josephvcaustin/SeniorDesign1/Rasberry Pi/Histogram Equalization/test_image3.jpg

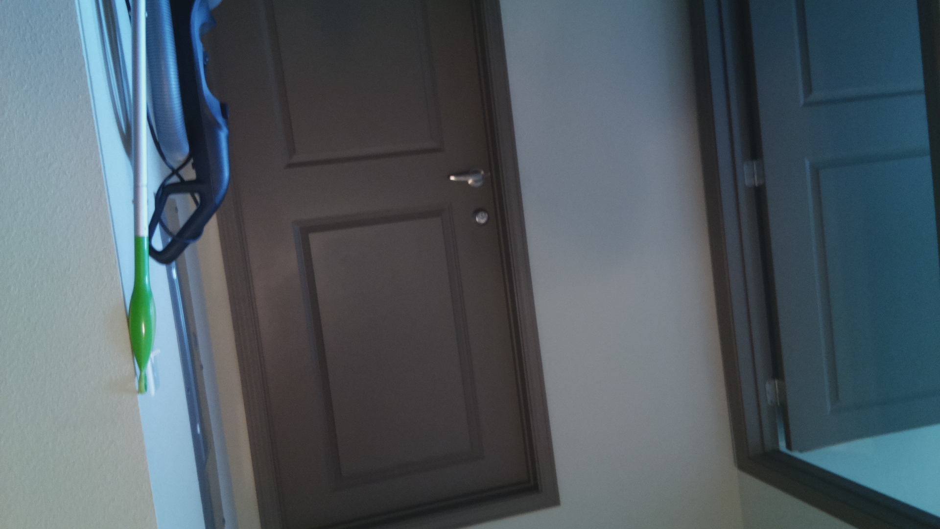
Rasberry Pi/Histogram Equalization/test_image3.jpg
