josephvcaustin/SeniorDesign1/Rasberry Pi/Interfacing and Testing Vehicle/CarRight.bmp

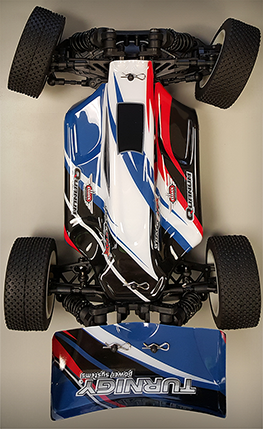
Rasberry Pi/Interfacing and Testing Vehicle/CarRight.bmp
