josephvcaustin/SeniorDesign1/README.md

# SeniorDesign1
A repository for all code related to the 2016 Senior Design Challenge at Oklahoma State University: the development of a high speed, autonomous, line-following vehicle.

For a video demonstration, see https://www.youtube.com/watch?v=CCHoqI0AoAU
