josephvcaustin/SeniorDesign1/Rasberry Pi/Camera/res.png

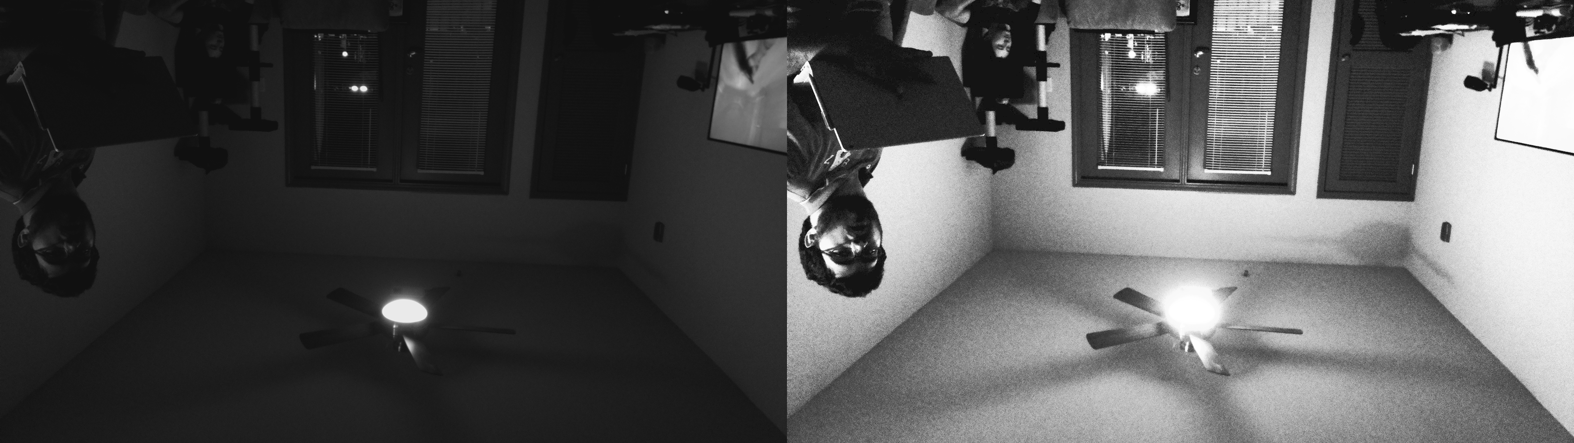
Rasberry Pi/Camera/res.png
