josephvcaustin/SeniorDesign1/Rasberry Pi/Camera/straight.png

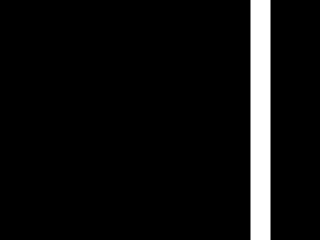
Rasberry Pi/Camera/straight.png
