josephvcaustin/SeniorDesign1/Rasberry Pi/Camera/turn2.png

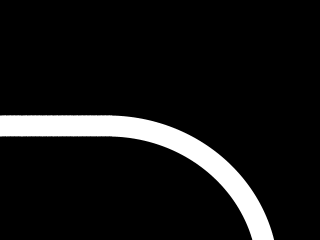
Rasberry Pi/Camera/turn2.png
