josephvcaustin/SeniorDesign1/Rasberry Pi/Camera/turn.png

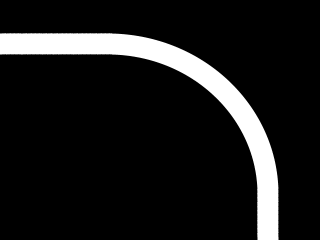
Rasberry Pi/Camera/turn.png
