josephvcaustin/SeniorDesign1/Rasberry Pi/Camera/test_image2.jpg

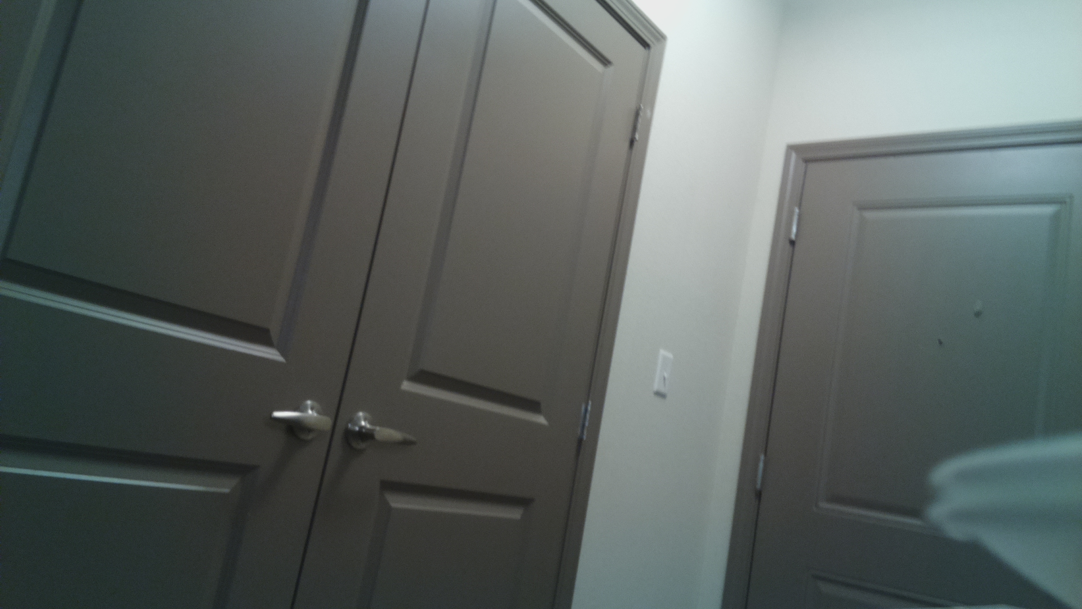
Rasberry Pi/Camera/test_image2.jpg
