josephvcaustin/SeniorDesign1/Rasberry Pi/Histogram Equalization/test_imag.jpg

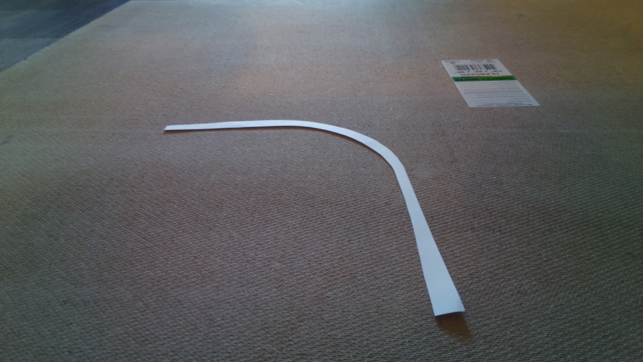
Rasberry Pi/Histogram Equalization/test_imag.jpg
