josephvcaustin/SeniorDesign1/Rasberry Pi/Histogram Equalization/test_image1.jpg

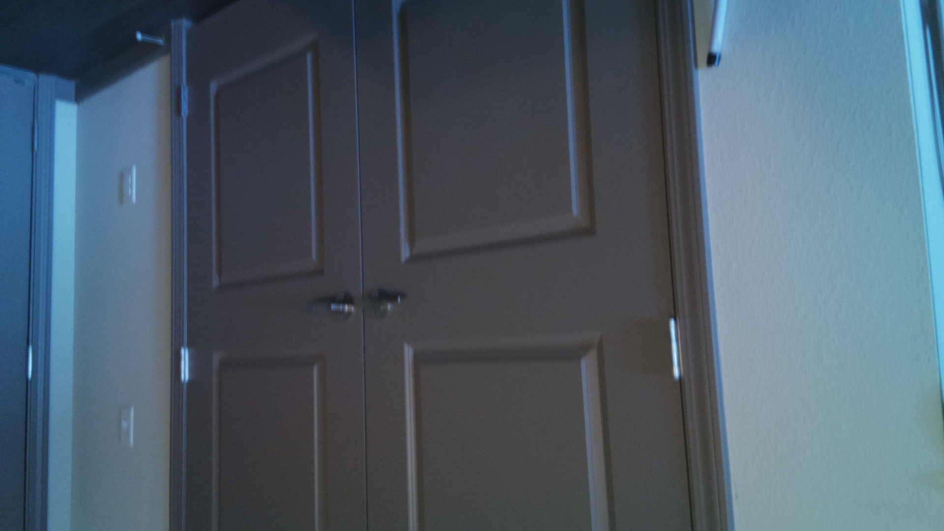
Rasberry Pi/Histogram Equalization/test_image1.jpg
