josephvcaustin/SeniorDesign1/Rasberry Pi/Histogram Equalization/test_image2.jpg

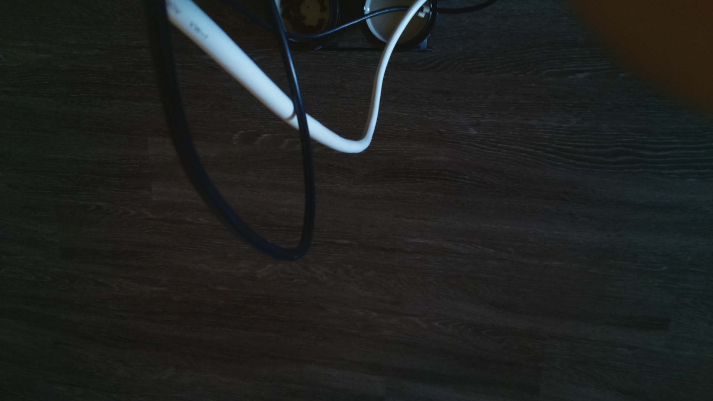
Rasberry Pi/Histogram Equalization/test_image2.jpg
