josephvcaustin/SeniorDesign1/Rasberry Pi/Interfacing and Testing Vehicle/a.png

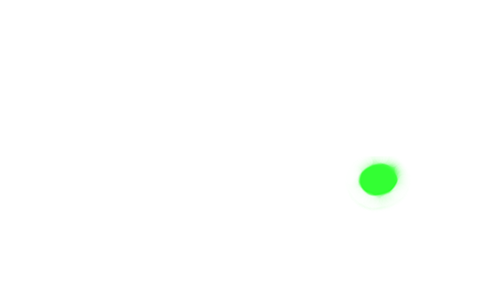
Rasberry Pi/Interfacing and Testing Vehicle/a.png
