josephvcaustin/SeniorDesign1/Rasberry Pi/Interfacing and Testing Vehicle/bk.png

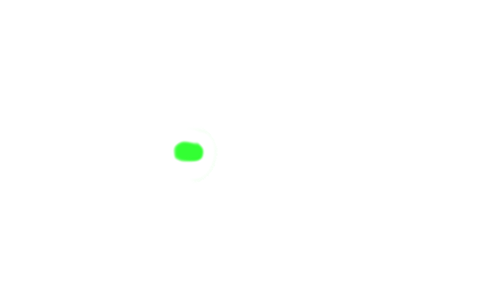
Rasberry Pi/Interfacing and Testing Vehicle/bk.png
