josephvcaustin/SeniorDesign1/Rasberry Pi/Interfacing and Testing Vehicle/CarLeft.bmp

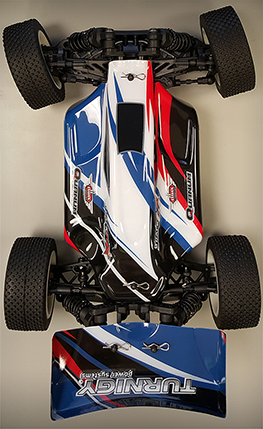
Rasberry Pi/Interfacing and Testing Vehicle/CarLeft.bmp
