josephvcaustin/SeniorDesign1/Rasberry Pi/Interfacing and Testing Vehicle/dd.png

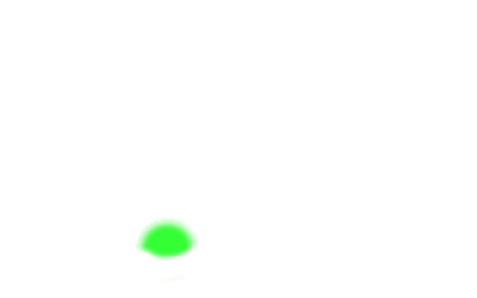
Rasberry Pi/Interfacing and Testing Vehicle/dd.png
