josephvcaustin/SeniorDesign1/Rasberry Pi/Interfacing and Testing Vehicle/dl.png

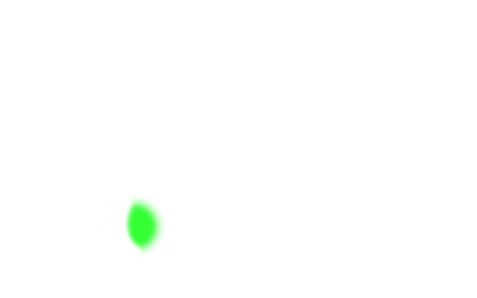
Rasberry Pi/Interfacing and Testing Vehicle/dl.png
