josephvcaustin/SeniorDesign1/Rasberry Pi/Interfacing and Testing Vehicle/gd.png

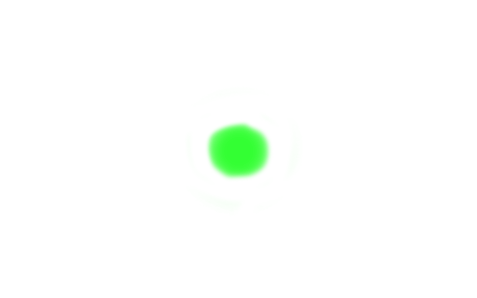
Rasberry Pi/Interfacing and Testing Vehicle/gd.png
