josephvcaustin/SeniorDesign1/Rasberry Pi/Interfacing and Testing Vehicle/lb.png

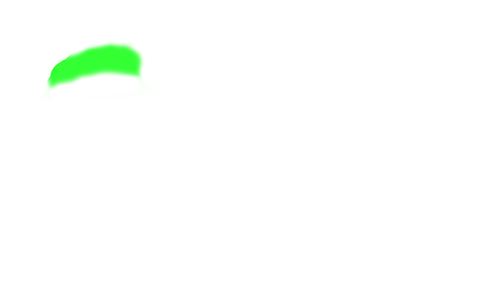
Rasberry Pi/Interfacing and Testing Vehicle/lb.png
