josephvcaustin/SeniorDesign1/Rasberry Pi/Interfacing and Testing Vehicle/lsd.png

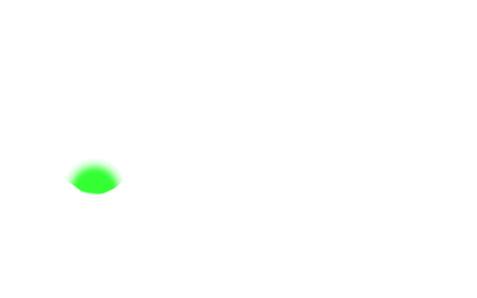
Rasberry Pi/Interfacing and Testing Vehicle/lsd.png
