josephvcaustin/SeniorDesign1/Rasberry Pi/Interfacing and Testing Vehicle/lsu.png

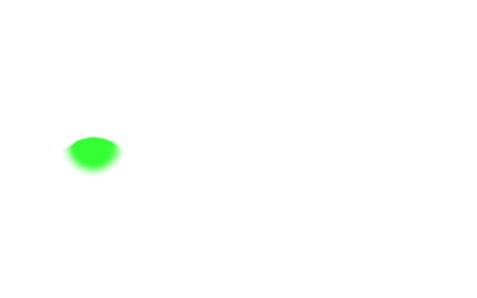
Rasberry Pi/Interfacing and Testing Vehicle/lsu.png
