josephvcaustin/SeniorDesign1/Rasberry Pi/Interfacing and Testing Vehicle/lt.png

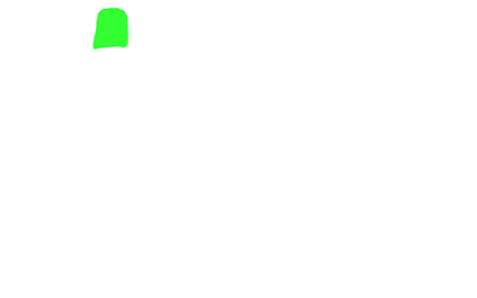
Rasberry Pi/Interfacing and Testing Vehicle/lt.png
