josephvcaustin/SeniorDesign1/Rasberry Pi/Interfacing and Testing Vehicle/rb.png

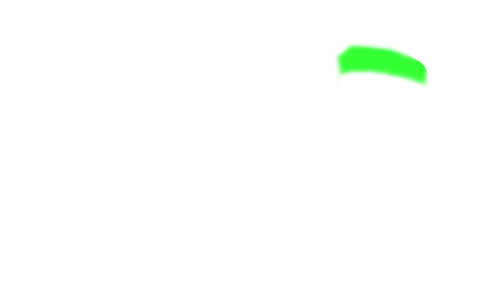
Rasberry Pi/Interfacing and Testing Vehicle/rb.png
