josephvcaustin/SeniorDesign1/Rasberry Pi/Interfacing and Testing Vehicle/rsd.png

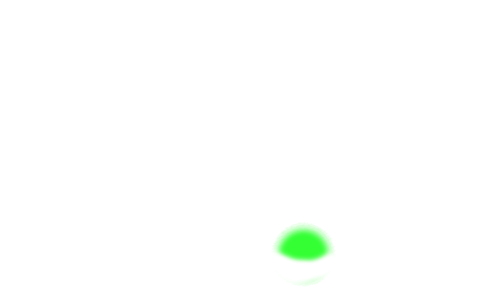
Rasberry Pi/Interfacing and Testing Vehicle/rsd.png
