josephvcaustin/SeniorDesign1/Rasberry Pi/Interfacing and Testing Vehicle/rt.png

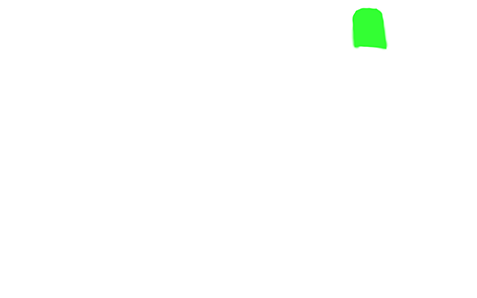
Rasberry Pi/Interfacing and Testing Vehicle/rt.png
