josephvcaustin/SeniorDesign1/Rasberry Pi/Interfacing and Testing Vehicle/x.png

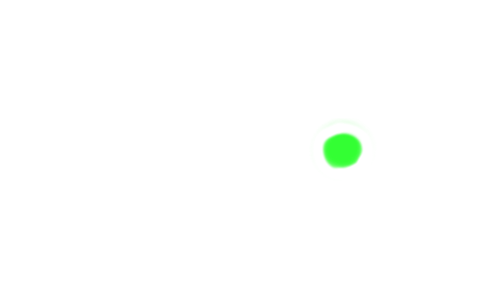
Rasberry Pi/Interfacing and Testing Vehicle/x.png
