josephvcaustin/SeniorDesign1/Rasberry Pi/Interfacing and Testing Vehicle/xbox.png

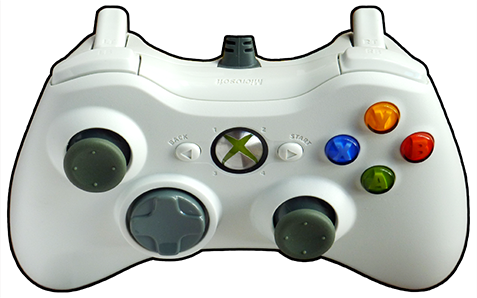
Rasberry Pi/Interfacing and Testing Vehicle/xbox.png
