josephvcaustin/SeniorDesign1/Rasberry Pi/Camera/Tests/image_capture_test.py

from picamera.array import PiRGBArray
from picamera import PiCamera
import time
import cv2

# initialize camera and grab ref
camera = PiCamera()
rawCapture = PiRGBArray(camera)

time.sleep(0.1)

camera.capture(rawCapture, format="bgr")
image = rawCapture.array

cv2.imshow("Image", image)
cv2.waitKey(0)
